ghddbwls/Capstone1/캡디/README.md

# 진동 이외의 햅틱 피드백이 가능한 게임 컨트롤러 제작 프로젝트

## About Project
- 현재 사용되는 게임 컨트롤러는 진동을 이용한 햅틱 피드백을 가능하게 하는 것이 일반적이다. 
- 본 프로젝트는 진동 이외의 햅틱 피드백이 가능한 게임 컨트롤러의 제작을 목표로 하며 공기압을 이용한 피드백을 이용한다.

## For Project
본 프로젝트를 위한 기기
- Game Controller - Switch Wing Controller (본 프로젝트 사용 모델, 기타 모델 사용 가능)
- Arduino UNO - 신호 제어
- TIP120 Mosfet Transister(4개) - Solenoid Valve 제어
- Diode 1N4007(4개) - Solenoid Valve 제어
- Solenoid Valve SC0526GC (4개) - 공기 입출력 제어
- CO2 Threaded cylinder - 공기탱크
- Air regulater - 공압 제어
- MT3608 DC-DC Step Up Module - 승압기

## To Use
- 설계도를 참조하여 Hardware를 제작 후 아두이노를 적용
- 게임에 즉시 적용 가능

## Contact
- 2015104233 홍유진 (2015104233@khu.ac.kr)
