ghddbwls/Capstone1/캡디/면담확인서/5월면담확인.pdf

## 캡스톤디자인 면담 확인서

팀원 | 홍유진
주제 | 진동 이외의 햅틱 피드백이 가능한 게임 컨트롤러 제작
면담일시 | 2020.05.02. 2020.05.06 | 지도교수 | 전석희 교수님 (인)

면

담

내

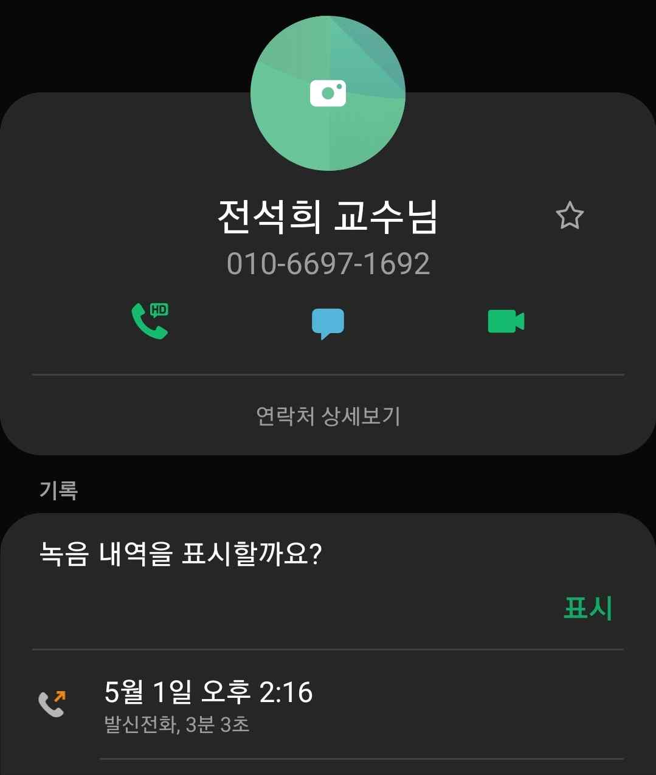
[picture p11: figure]

용

5월 1일
전화로 면담을 진행함. 당일까지의 프로젝트 진행 상황 및 앞으로의 진행 방

향을 정하고 프로젝트 진행에 필요한 기기를 받을 예 정을 잡음. 5월 6일

담당 교수님의 연구실을 방문, 프로젝트 진행에 필요 한 공기탱크, Regulator 및 기타 장비를 받음.
