ghddbwls/Capstone1/캡디/면담확인서/3월면담확인.pdf

## 캡스톤디자인 면담 확인서

팀원 | 홍유진
주제 | 진동 이외의 햅틱 피드백이 가능한 게임 컨트롤러
면담일시 | 2020.03.27. | 지도교수 | 전석희 (인)

면

담

내

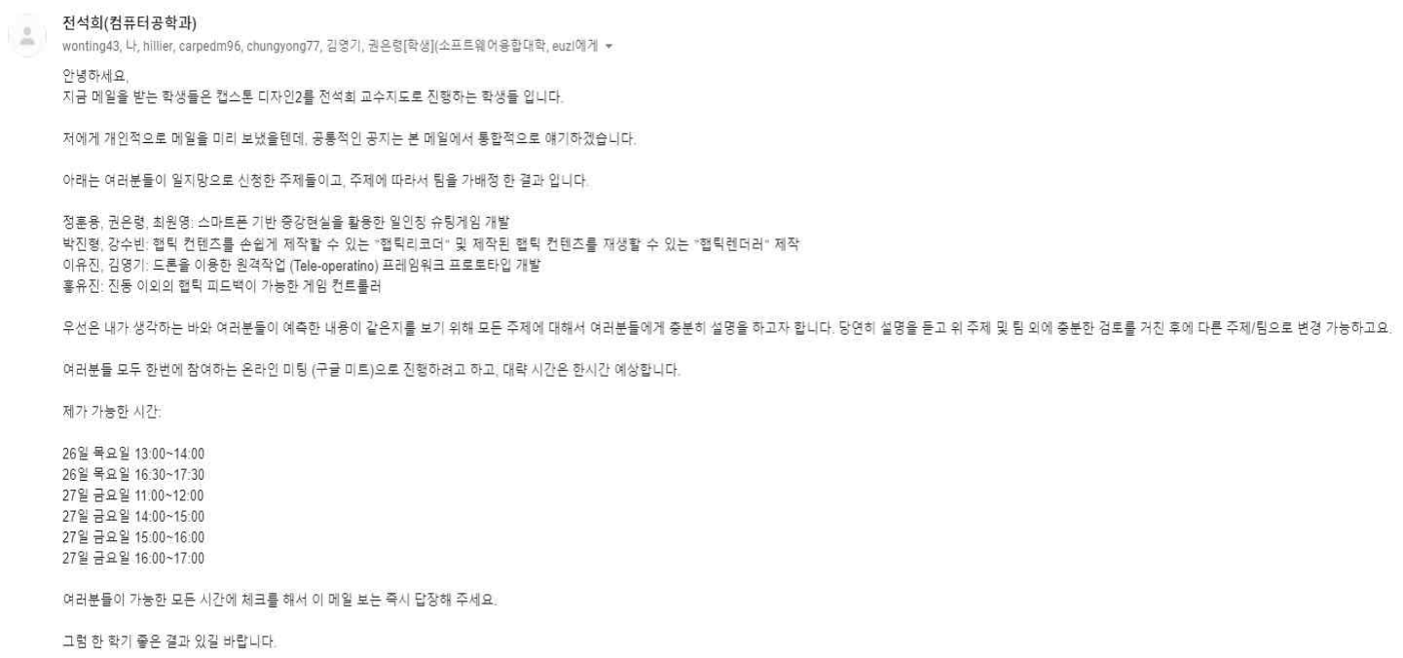
[picture p12: figure]

용

이메일을 통해 3월 27일 오후 2시에 Google Meet를 이용해 면담을 진행하기로 결정함. 3월 27일 오후 2시부터 면담을 진행함. 면담 내용은 주제에 대한 자세한 설명과 주제 선정 재

확인, 앞으로의 일정에 대한 설명이었음. 그 후, 이메일을 통해 팀원의 연락처 교환과 다음 면

담일정을 확인함.

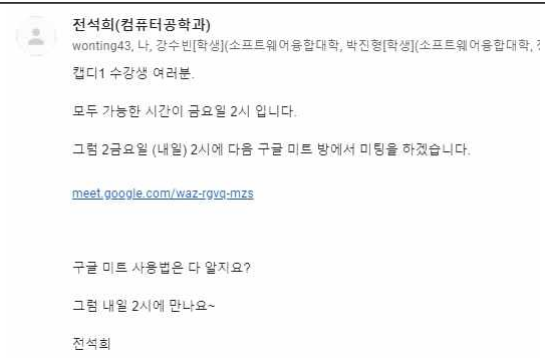
[picture p13: figure]
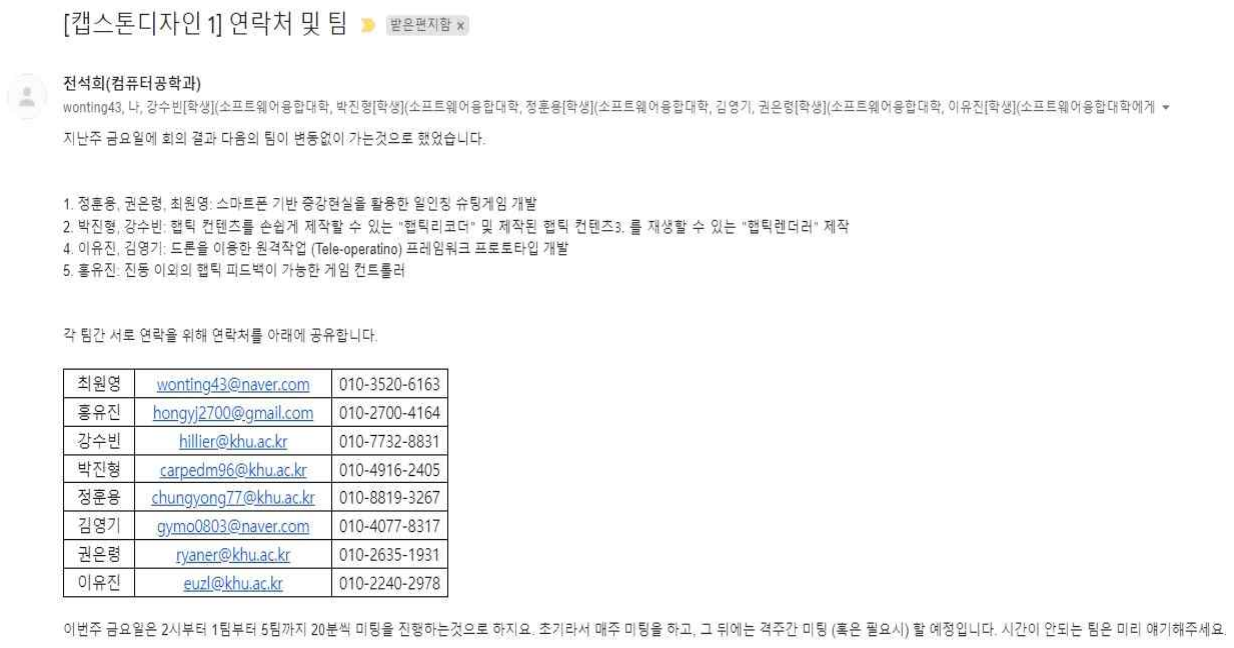
[picture p14: figure]
