ghddbwls/Capstone1/캡디/면담확인서/4월면담확인.pdf

## 캡스톤디자인 면담 확인서

팀원 | 홍유진
주제 | 진동 이외의 햅틱 피드백이 가능한 게임 컨트롤러 제작
면담일시 | 2019. 04. 10. 2019. 04. 27. | 지도교수 | 전석희 교수님 (인)

면

담

내

용

4월 10일
이메일을 통해 프로젝트의 진행 상태를 보고하고 그 와 관련하여 질문을 함. 이후 전화 통화를 통해 질문에 대한 대답과 주제에

대한 재정의를 진행함. 이후 프로젝트 진행 방향을 설명. 4월 27일

4월 10일 이후의 프로젝트 진행을 이메일로 보고하 고 그에 관한 면담을 신청함. 5월 1일 오후 2시경에 구글 meet를 통해 면담을 가

질 것.

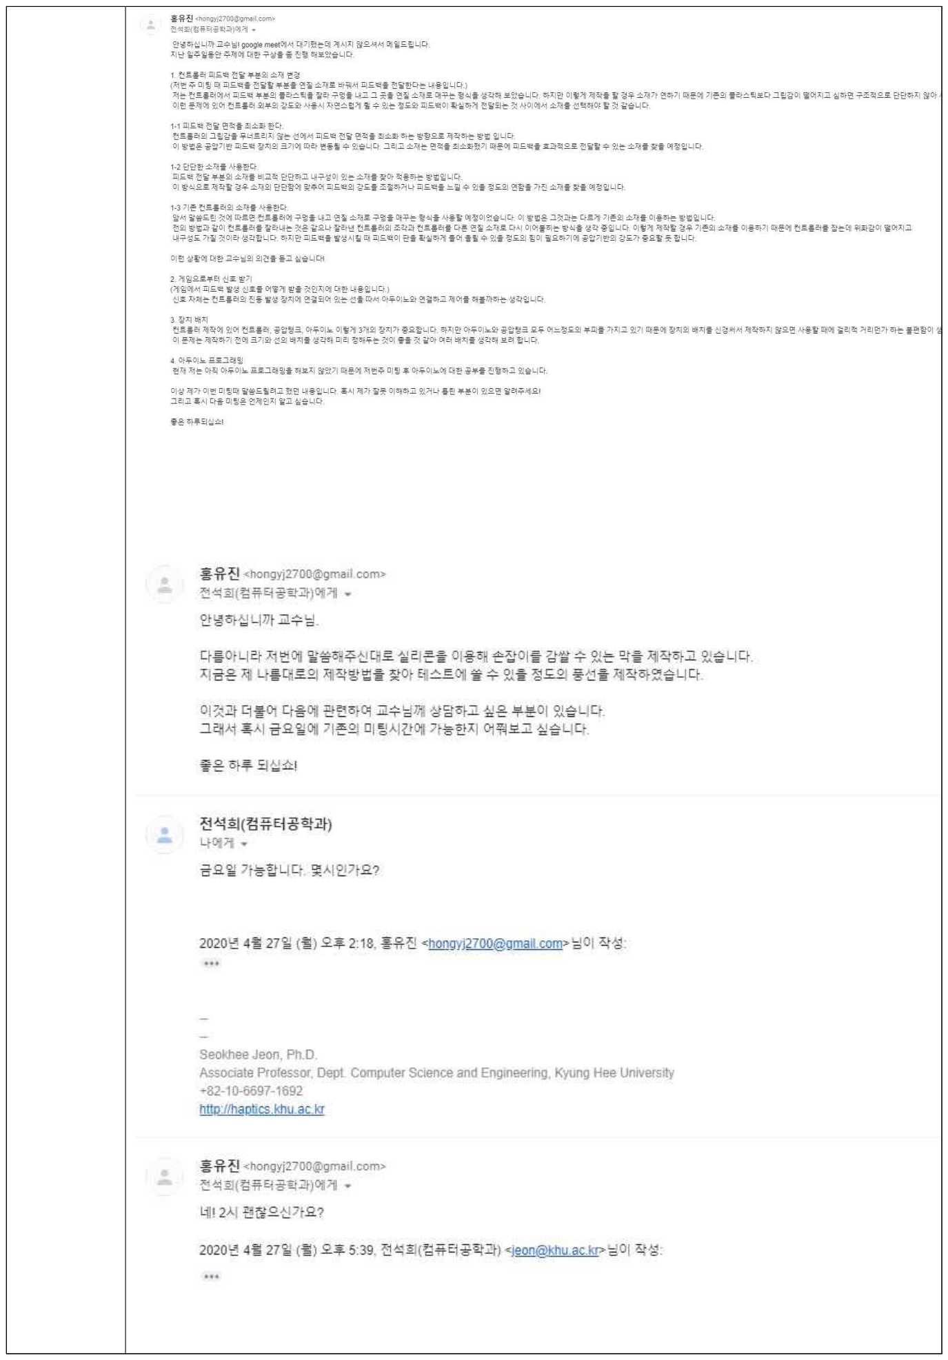
[picture p15: page 2]
