ghddbwls/Capstone1/캡디/면담확인서/6월면담확인.pdf

# 캡스톤디자인 면담 확인서

팀원 | 홍유진
주제 | 진동 이외의 햅틱 피드백이 가능한 게임 컨트롤러 제작
면담일시 | 2020.06.10. 2020.06.19. | 지도교수 | 전석희 교수님 (인)

면

담

내

용

6월 10일

## 결과물 시연에 대한 공지 전달

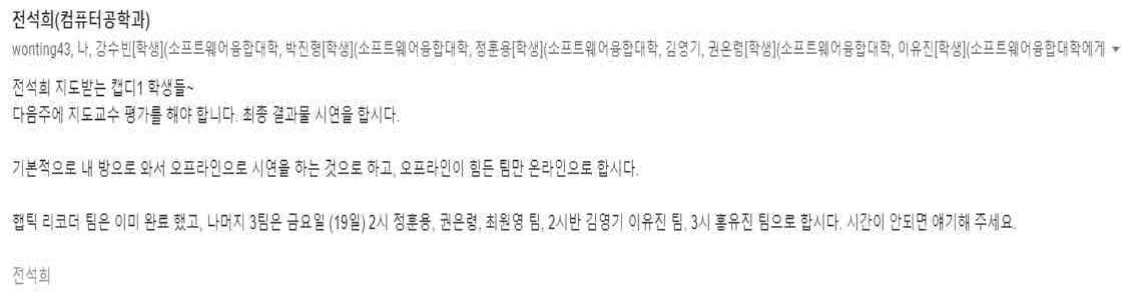
[picture p16: figure]

6월 19일

## 오후 3시부터 결과물 시연, 향후 연구에 대한 면담
